igorSeberino/iot.sala/docs/registro-ia.md

# Registro de uso de inteligência artificial

Uma linha por uso, na ordem em que aconteceu. Quem usou IA numa tarefa acrescenta a linha antes
de fechar a issue.

| # | Ferramenta | Para que | Pedido feito | O que aceitamos | O que rejeitamos | O que mudamos depois |
|---|---|---|---|---|---|---|
| 1 | Claude (Anthropic) | Sugerir um uso simples e organizar tópicos e diagrama da etapa 1 | "Planejar a etapa 1 da N3: uso, tópicos MQTT e diagrama, de forma simples" | Monitor de temperatura com LED, os 4 tópicos, uso de Last Will e retain | (preencher pela equipe) | Revisado no uso 2: broker, QoS do ESP32, payload da temperatura, queda do broker e nome de integrante |
| 2 | Claude (Anthropic), no Hermes Agent | Conferir o documento da etapa 1 contra o enunciado, corrigir erros e montar o repositório, o plano e as issues | "Verifique se o documento segue o escopo do projeto (para a sua data de entrega atual) e crie um repositório no github a partir dele, para executar o projeto. Se o documento tiver erros, pode corrigir." | (preencher pela equipe; correções propostas em `docs/plano/00-visao-geral.md` §3) | (preencher pela equipe) | (preencher pela equipe) |
| 3 | Claude (Anthropic), no Claude Code | Escrever o firmware da etapa de 4/11 (#2 e #3), compilar para ESP32, testar o broker e escrever como conferir no MQTT Explorer (README §8) | "Te enviei o repositório do trabalho e o que deve ser feito. A entrega de hoje é essa: Semana de 4/11: dispositivo lendo o sensor e publicando no broker, conferido num cliente MQTT. Precisamos fazer a entrega de hoje, faça." | (preencher pela equipe depois de gravar no ESP32 e conferir no MQTT Explorer) | (preencher pela equipe) | (preencher pela equipe) |
| 4 | Claude (Anthropic), no Claude Code | Montar o circuito na protoboard, conferir a montagem pelas fotos, gravar o ESP32, diagnosticar o DHT11 que não respondia e configurar o MQTT Explorer | "Quais peças precisamos", "me explica melhor onde encaixo cada coisa", "vê se tá tudo certo", "tente de novo, fiz as mudanças", "não consegue fazer direto por lá e eu só tirar os prints?" | Desenhos de montagem furo a furo; sensor virado (estava de frente para os fios); hotspot no lugar da rede da faculdade; montagem descida para as fileiras 31 a 42 | (preencher pela equipe) | (preencher pela equipe) |
| 5 | Claude (Anthropic), no Claude Code | Etapa de 11/11: comando do LED no firmware (#4), dashboard (#5), testes com a placa e correção da montagem do LED | "Agora estamos na semana 11/11, o que é preciso ser feito", "faz os dois", "o LED não liga, veja se está tudo certo na montagem" | Firmware com assinatura do comando e confirmação do estado; dashboard em um arquivo só; LED direto na fileira do GND (sem ponte) | (preencher pela equipe) | Resistor de 1 kΩ no lugar do de 220 Ω, por ser o que havia no kit |
