igorSeberino/iot.sala/(commit log)

2026-10-29 docs: etapa 1 — uso, tópicos MQTT, diagrama, configuração de exemplo e plano
2026-10-29 docs: corrige GPIO 2, troca de broker, casas decimais e assinatura de lerTemperatura
    [config.example.h]
2026-11-11 feat: etapa de 4/11 — ESP32 lendo o DHT11 e publicando no broker (#2, #3)
    - firmware/monitor_sala/monitor_sala.ino: lê o DHT11 a cada 5 s com
    lerTemperatura() (NAN em caso de falha, sem publicar), publica em
    .../sala/temperatura com 1 casa decimal (QoS 0, sem retain), status
    "online" retido, Last Will "offline" (QoS 1, retido), client ID com o
    MAC da placa e reconexão de Wi-Fi e broker a cada 5 s sem delay() no loop
    - README §2 e §5: DHT11 solto de 4 pinos com resistor de 10 kΩ de pull-up
    e a montagem da equipe na protoboard, furo a furo
    - README §8: como gravar, conferir no MQTT Explorer, problemas que já
    tivemos e o resultado de 04/11 com os prints em docs/evidencias/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
    [config.example.h, monitor_sala.ino]
2026-11-11 feat: etapa de 11/11 — comando do LED no ESP32 e dashboard (#4, #5)
    - firmware/monitor_sala/monitor_sala.ino: assina .../ventilador/comando
    (QoS 1) a cada conexão; ON acende o LED no GPIO 2 e só depois publica
    LIGADO retido em .../ventilador/estado; OFF apaga e publica DESLIGADO;
    outras mensagens são ignoradas; a placa liga com o LED apagado e
    publica o estado atual a cada (re)conexão
    - dashboard/index.html: página única com MQTT.js por WebSocket seguro
    (8884); mostra em texto a temperatura, o aviso ACIMA DO LIMITE acima de
    28 °C, o ventilador (só pela confirmação do ESP32), o dispositivo e o
    broker; botões Ligar/Desligar publicam ON/OFF com QoS 1 e sem retain
    - RE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
    [monitor_sala.ino]
